ICFOSS-IoT/Weather_Monitor/Hardware/Version_1/KiCAD_Files/Schematic.pdf

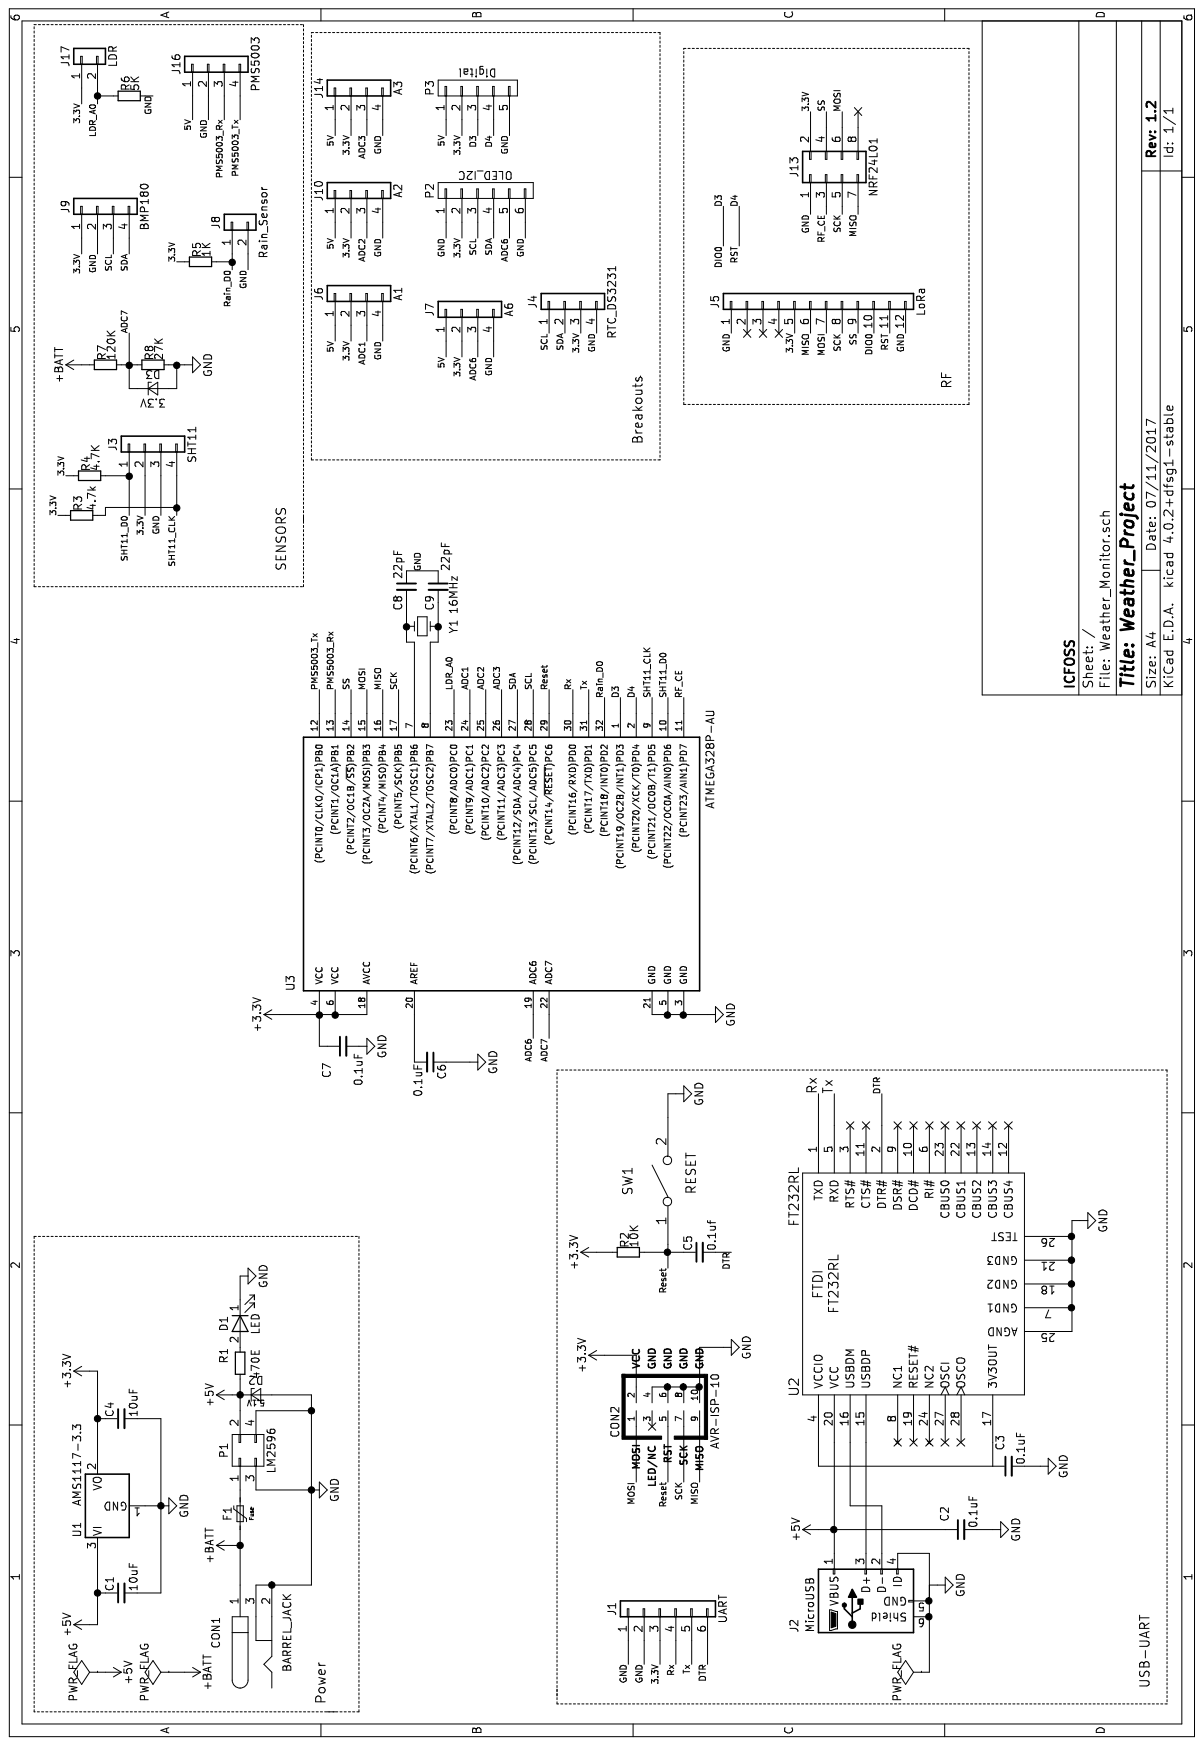
[picture p1: page 1]
