ICFOSS-IoT/Weather_Monitor/Hardware/Version_1/KiCAD_Files/Weather_Monitor.kicad_pcb

## KiCad design Hardware/Version_1/KiCAD_Files/Weather_Monitor.kicad_pcb (2017-11-15)

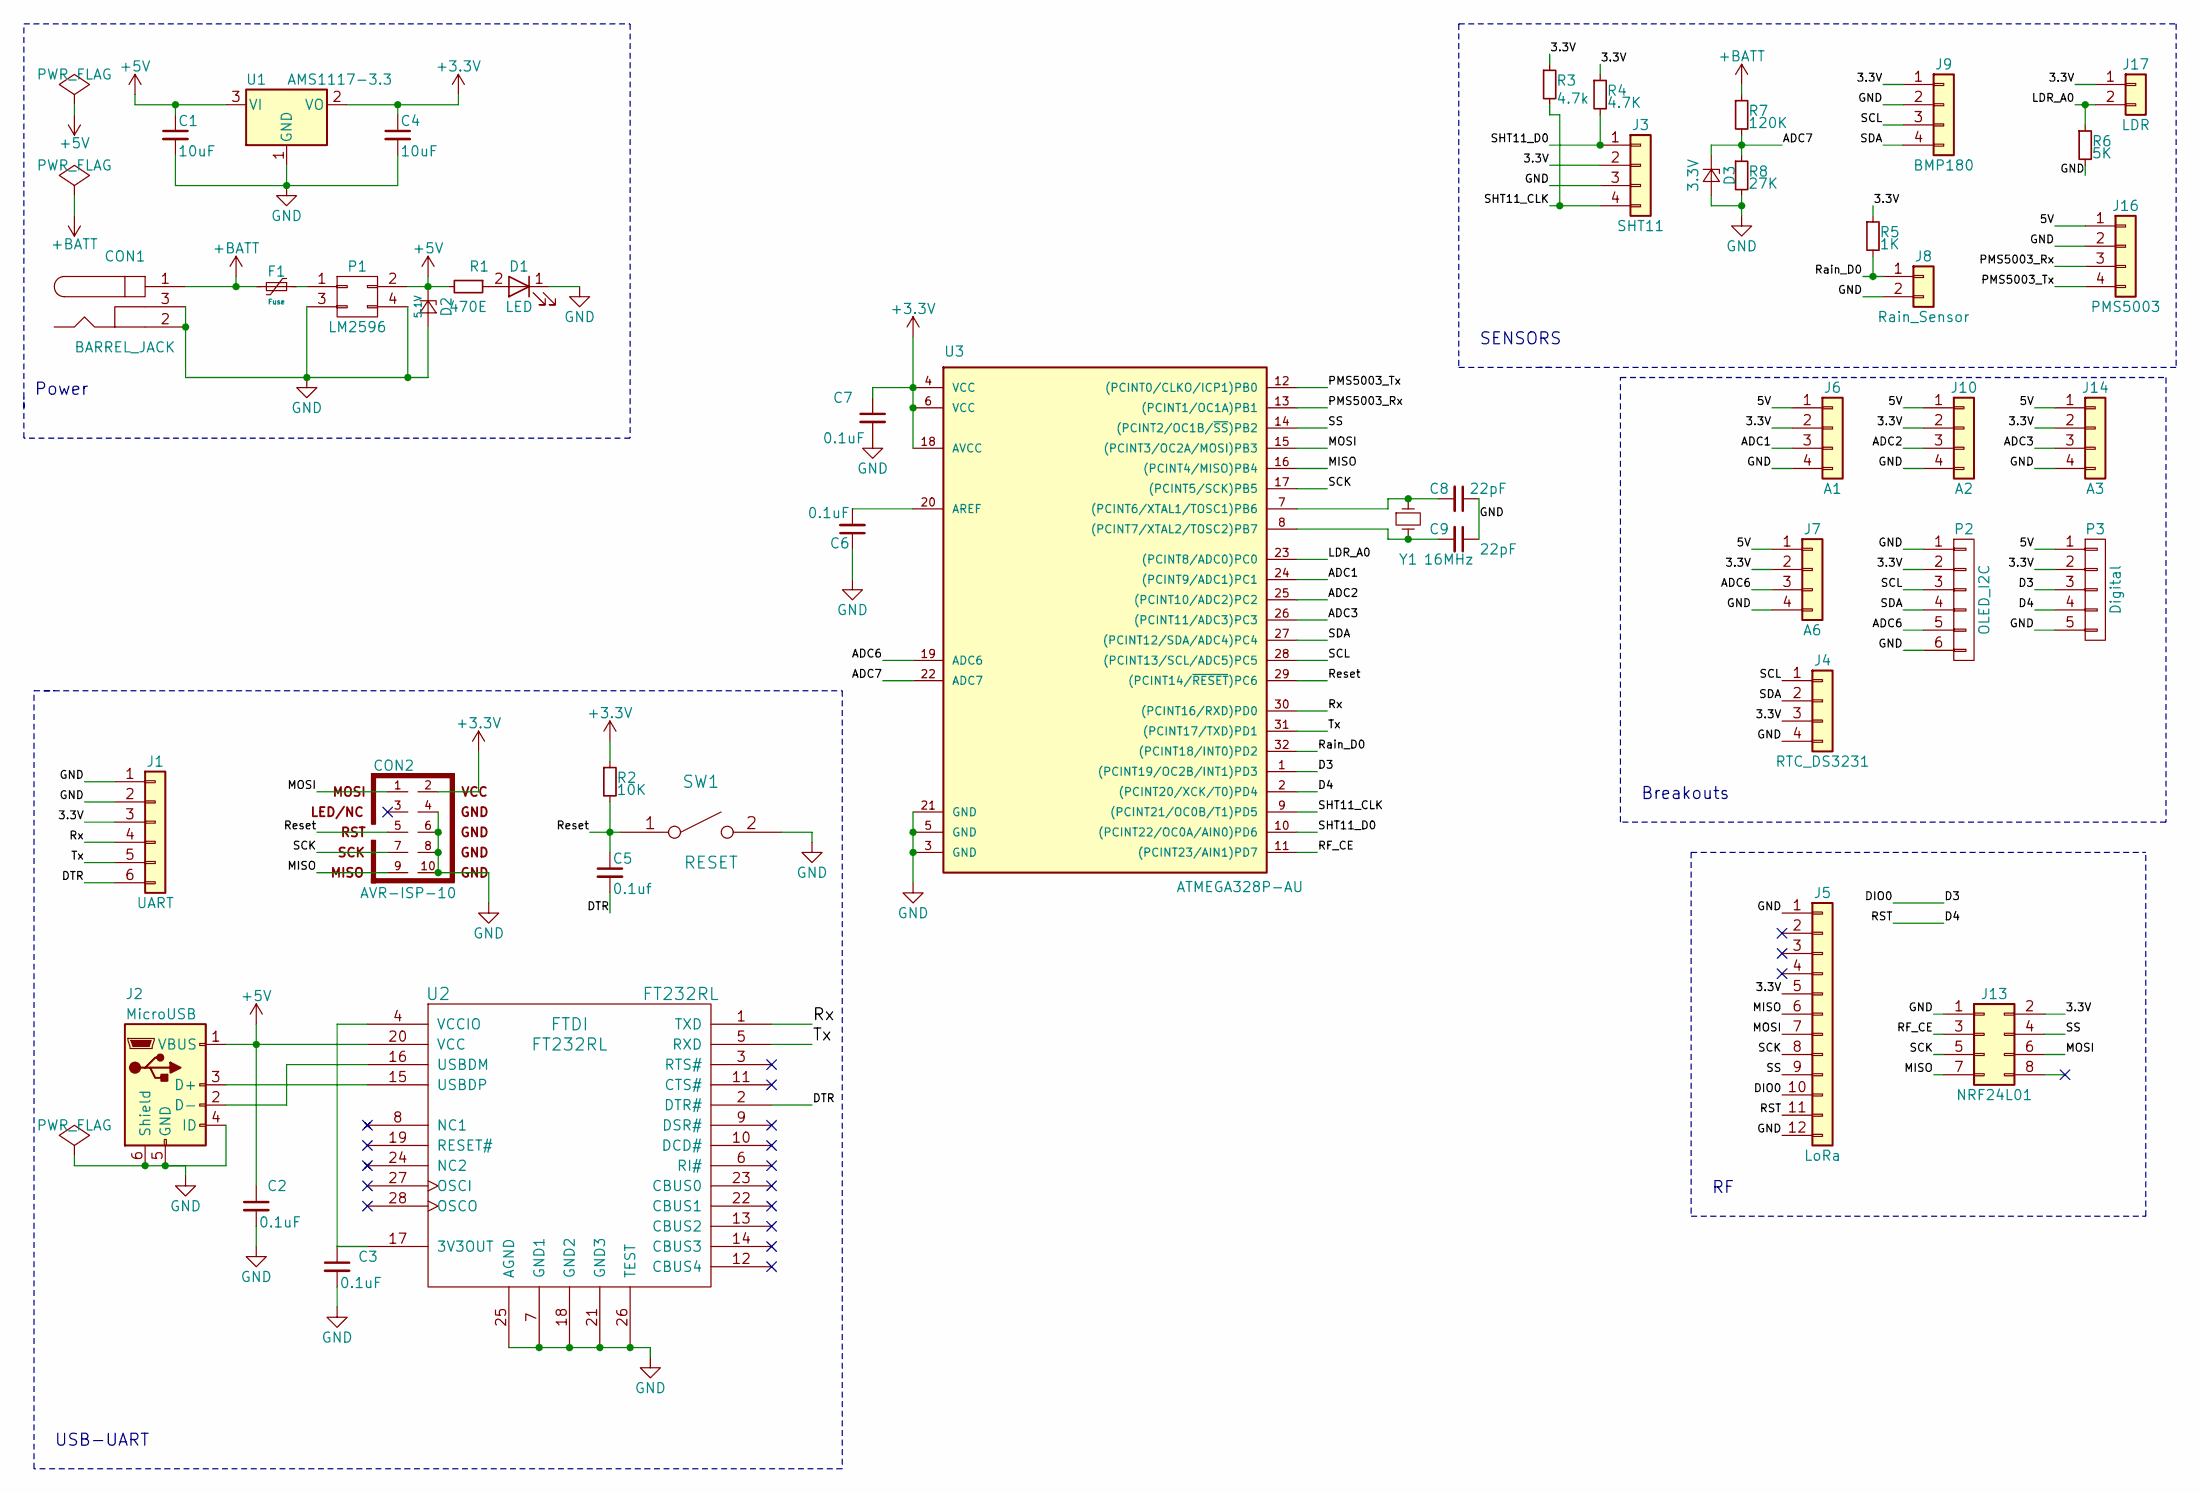
[picture p2: schematic Weather_Monitor.sch]

Parts:
C1, C4: 10uF; CP_Tantalum_Case-B_EIA-3528-21_Hand
C2, C3, C6, C7: 0.1uF; C_0805
C5: 0.1uf; C_0805
C8, C9: 22pF; C_0805
CON1: BARREL_JACK
CON2: AVR-ISP-10; IDC-Header_2x05_Pitch2.54mm_Straight
D1: LED; LED_0805
D2: 5.1V; D_SOD-123F
D3: 3.3V; D_SOD-123F
F1: Fuse; Fuse_SMD2920
J1: UART; Pin_Header_Straight_1x06_Pitch2.54mm
J2: MicroUSB; USB_Micro-B
J3: SHT11; Pin_Header_Straight_1x04_Pitch2.54mm
J4: RTC_DS3231; Pin_Header_Straight_1x04_Pitch2.54mm
J5: LoRa; XL_1278-SMT(SX1278)
J6: A1; Pin_Header_Straight_1x04_Pitch2.54mm
J7: A6; Pin_Header_Straight_1x04_Pitch2.54mm
J8: Rain_Sensor; Pin_Header_Straight_1x02_Pitch2.54mm
J9: BMP180; Pin_Header_Straight_1x04_Pitch2.54mm
J10: A2; Pin_Header_Straight_1x04_Pitch2.54mm
J13: NRF24L01; Pin_Header_Straight_2x04_Pitch2.54mm
J14: A3; Pin_Header_Straight_1x04_Pitch2.54mm
J16: PMS5003; Pin_Header_Straight_1x04_Pitch2.54mm
J17: LDR; Pin_Header_Straight_1x02_Pitch2.54mm
P1: LM2596
P2: OLED_I2C; Pin_Header_Straight_1x06_Pitch2.54mm
P3: Digital; Pin_Header_Straight_1x05_Pitch2.54mm
R1: 470E; R_0805
R2: 10K; R_0805
R3: 4.7k; R_0805
R4: 4.7K; R_0805
R5: 1K; R_0805
R6: 5K; R_0805
R7: 120K; R_0805
R8: 27K; R_0805
SW1: RESET; SW_PUSH_6mm
U1: AMS1117-3.3; SOT-223-3_TabPin2
U2: FT232RL; SSOP-28_5.3x10.2mm_Pitch0.65mm; MPN FT232RL
U3: ATMEGA328P-AU; TQFP-32_7x7mm_Pitch0.8mm
Y1: 16MHz; Crystal_HC49-U_Vertical

Connections:
+3V3: C4.1, C7.1, CON2.2, R2.1, U1.2 (VO), U3.4 (VCC), U3.6 (VCC), U3.18 (AVCC)
+5V: C1.1, C2.1, D2.1 (K), J2.1 (VBUS), P1.2, R1.2, U1.3 (VI), U2.20 (VCC)
+BATT: CON1.1, F1.2, R7.1
/3.3V: J1.3, J3.2, J4.3, J5.5, J6.2, J7.2, J9.1, J10.2, J13.2, J14.2, J17.1, P2.2, P3.2, R3.1, R4.1, R5.1
/5V: J6.1, J7.1, J10.1, J14.1, J16.1, P3.1
/ADC1: J6.3, U3.24 ((PCINT9/ADC1)PC1)
/ADC2: J10.3, U3.25 ((PCINT10/ADC2)PC2)
/ADC3: J14.3, U3.26 ((PCINT11/ADC3)PC3)
/ADC6: J7.3, P2.5, U3.19 (ADC6)
/ADC7: D3.1 (K), R7.2, R8.1, U3.22 (ADC7)
/D3: J5.10, P3.3, U3.1 ((PCINT19/OC2B/INT1)PD3)
/D4: J5.11, P3.4, U3.2 ((PCINT20/XCK/T0)PD4)
/DTR: C5.2, J1.6, U2.2 (DTR#)
/LDR_A0: J17.2, R6.1, U3.23 ((PCINT8/ADC0)PC0)
/MISO: CON2.9, J5.6, J13.7, U3.16 ((PCINT4/MISO)PB4)
/MOSI: CON2.1, J5.7, J13.6, U3.15 ((PCINT3/OC2A/MOSI)PB3)
/PMS5003_Rx: J16.3, U3.13 ((PCINT1/OC1A)PB1)
/PMS5003_Tx: J16.4, U3.12 ((PCINT0/CLKO/ICP1)PB0)
/RF_CE: J13.3, U3.11 ((PCINT23/AIN1)PD7)
/Rain_D0: J8.1, R5.2, U3.32 ((PCINT18/INT0)PD2)
/Reset: C5.1, CON2.5, R2.2, SW1.1, U3.29 ((PCINT14/~RESET~)PC6); also elsewhere on the board
/Rx: J1.4, U2.1 (TXD), U3.30 ((PCINT16/RXD)PD0)
/SCK: CON2.7, J5.8, J13.5, U3.17 ((PCINT5/SCK)PB5)
/SCL: J4.1, J9.3, P2.3, U3.28 ((PCINT13/SCL/ADC5)PC5)
/SDA: J4.2, J9.4, P2.4, U3.27 ((PCINT12/SDA/ADC4)PC4)
/SHT11_CLK: J3.4, R3.2, U3.9 ((PCINT21/OC0B/T1)PD5)
/SHT11_D0: J3.1, R4.2, U3.10 ((PCINT22/OC0A/AIN0)PD6)
/SS: J5.9, J13.4, U3.14 ((PCINT2/OC1B/~SS~)PB2)
/Tx: J1.5, U2.5 (RXD), U3.31 ((PCINT17/TXD)PD1)
GND: C1.2, C2.2, C3.2, C4.2, C6.1, C7.2, C8.1, C9.1, CON1.2, CON1.3, CON2.4, CON2.6, CON2.8, CON2.10, D1.1 (K), D2.2 (A), D3.2 (A), J1.1, J1.2, J2.4 (ID), J2.5 (GND), J2.6 (Shield), J3.3, J4.4, J5.1, J5.12, J6.4, J7.4, J8.2, J9.2, J10.4, J13.1, J14.4, J16.2, P1.3, P1.4, P2.1, P2.6, P3.5, R6.2, R8.2, SW1.2, U1.1 (GND), U2.7 (GND1), U2.18 (GND2), U2.21 (GND3), U2.25 (AGND), U2.26 (TEST), U3.3 (GND), U3.5 (GND), U3.21 (GND); also elsewhere on the board
unnamed: C3.1, U2.4 (VCCIO), U2.17 (3V3OUT)
unnamed: C6.2, U3.20 (AREF)
unnamed: C8.2, U3.7 ((PCINT6/XTAL1/TOSC1)PB6), Y1.1
unnamed: C9.2, U3.8 ((PCINT7/XTAL2/TOSC2)PB7), Y1.2
unnamed: D1.2 (A), R1.1
unnamed: F1.1, P1.1
unnamed: J2.2 (D-), U2.16 (USBDM)
unnamed: J2.3 (D+), U2.15 (USBDP)

Notes on the sheet:
SENSORS
Breakouts
USB-UART
Power

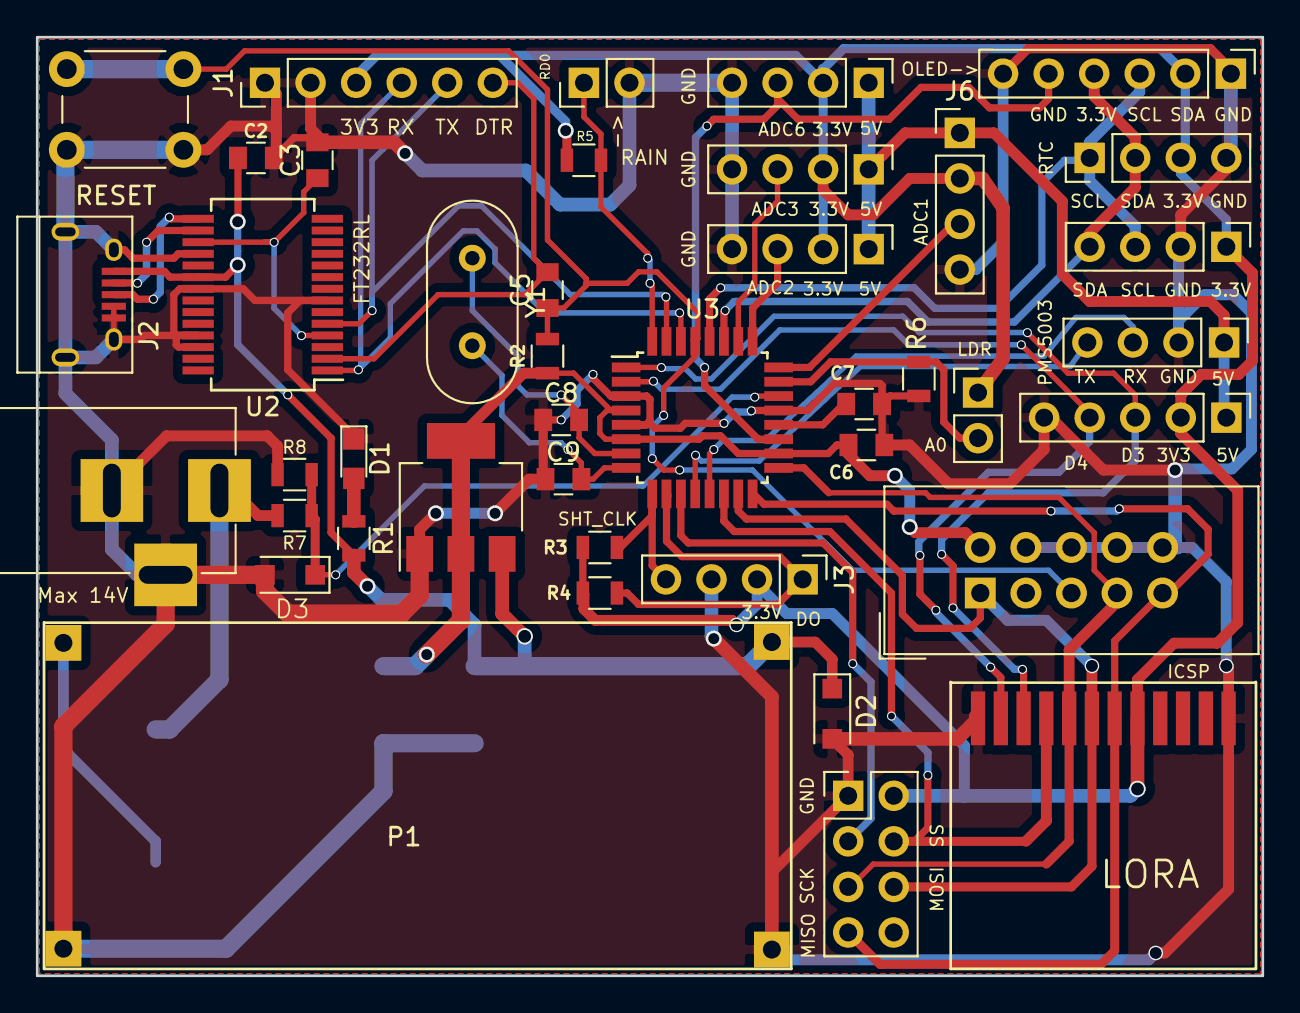
[picture p3: board Weather_Monitor.kicad_pcb from above]

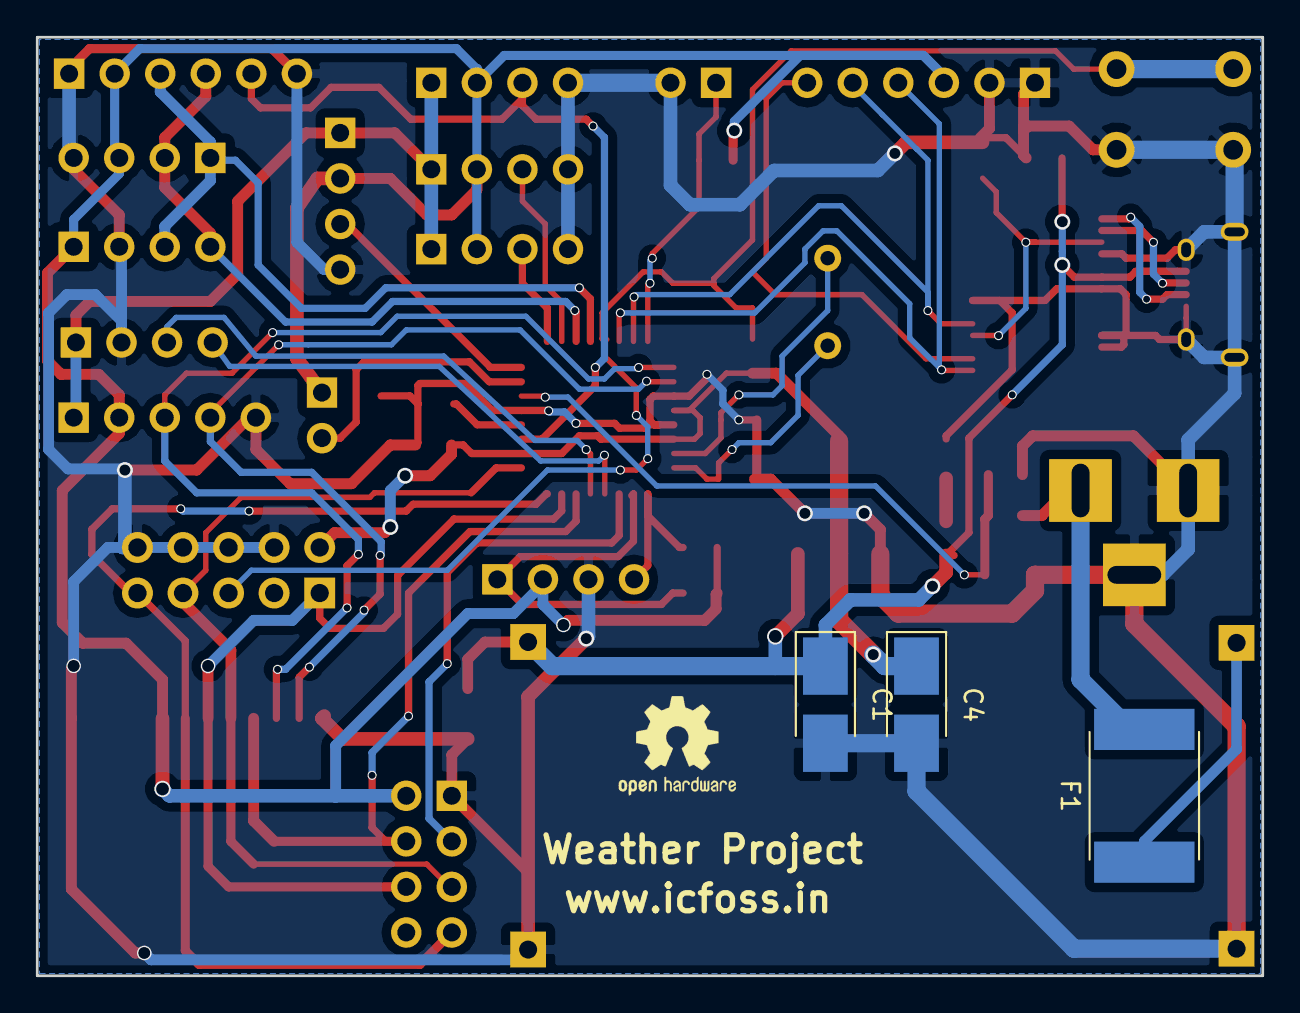
[picture p4: board Weather_Monitor.kicad_pcb from below]

Board: 2 copper layers, 68.3 x 52.3 mm, 45 parts (3 on the bottom side), 38 nets.

Other parts of the board:
RESET: RESET; SW_PUSH_6mm

Their connections:
/Reset: RESET.1; also elsewhere on the board
GND: RESET.2; also elsewhere on the board
